Nabizzle/Hexapod/Docs/Kinematics Calculations/Hexapod Kinematics Calculation.pdf

# Kinematics Calculations for Hexapod Robot

### Nabeel Chowdhury

### October 10, 2021

1

## 1 Servo Angles for each Leg

Looking from above, the first angle of each leg that makes contact with the floor at P(x, y, z) is found as θC = tan⁻¹

Ly
Lx
= tan⁻¹
Py
Px

x

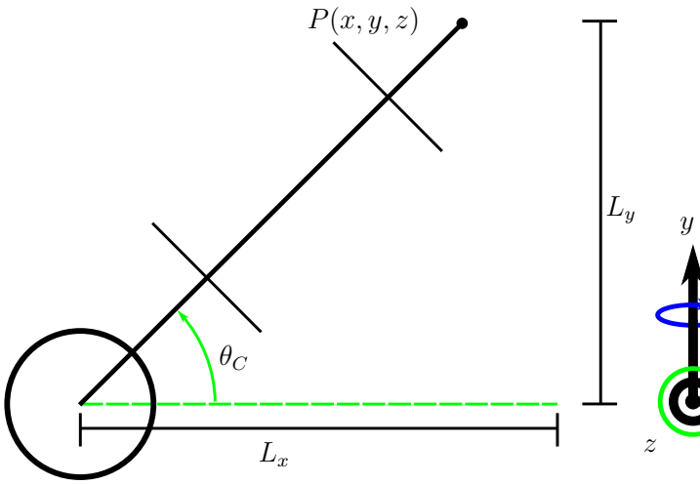
[picture p3: figure]

Figure 1: The top view of the leg. θC is the Coax angle of the servo attached to the body of the Hexapod. Lx is the length of the leg from the body in the x direction and Ly is the length of the leg in the y direction.

2

Looking from the side of the leg, we can define several parameters.

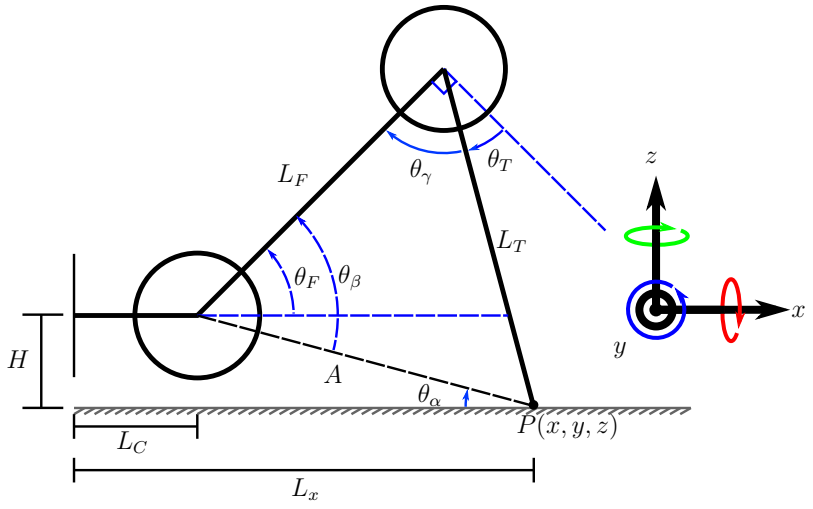
[picture p4: figure]

Figure 2: The side view of the leg. θF is the Femur angle and θT is the tibia angle. LC is the offset of the femur servo from the body, or the coax length. LF is the length of the Femur and LT is the length of the Tibia. Lx is the x distance of the leg’s point of contact with the ground. H is the height of the body off of the ground. The rest of the parameters are needed in interim steps to find θF and θT .

First, we need to find the length of A.

A =

q
H² + (Lx − LC)

2 =

q
P²
z + (Px − LC)

2

Using A we can use the law of cosines to find θF .

θF = θβ − θα

θα = tan⁻¹

H
Lx − LC

L

2
T = L

2
F + A

2 − 2LFA cos(θβ)

∴ θF = cos⁻¹

L

2
T − L

2

F − A²
−2LFA
− tan⁻¹
H
Px − LC

3

We can also use the law of cosines to find the tibia angle as well.

−θT = 90◦ − θγ

A

2 = L

2
F + L

2
T − 2LF LT cos(θγ)

∴ θT = cos⁻¹

A² − L

2
F − L

2
T
−2LF LT
− 90◦

In summary:

θC = tan⁻¹

Py
Px

θF = cos⁻¹

L

2
T − L

2
F − P

2
z − (Px − LC)

2

−2LF

q
P²
z + (Px − LC)

2

⁻ tan⁻¹

−Pz
Px − LC

θT = cos⁻¹

P

2
z + (Px − LC)

2 − L
2
F − L

2
T
−2LF LT

!
− 90◦

4

## 2 Converting Leg Origin to Body Origin

In order to find how all of the legs will move together, the origins of each leg need to be shifted from their body attachment points to the body center. Shown in the image below is a top down view of the hexapod body with the leg attachment points labeled as xn, yn, zn with n = 0, 1, 2, 3, 4, 5 to corre-spond to the leg numbers in the code. in the default position, the offset of the legs from the body are a known number, but each offset will change as the body rotates in place. This will be explored later.

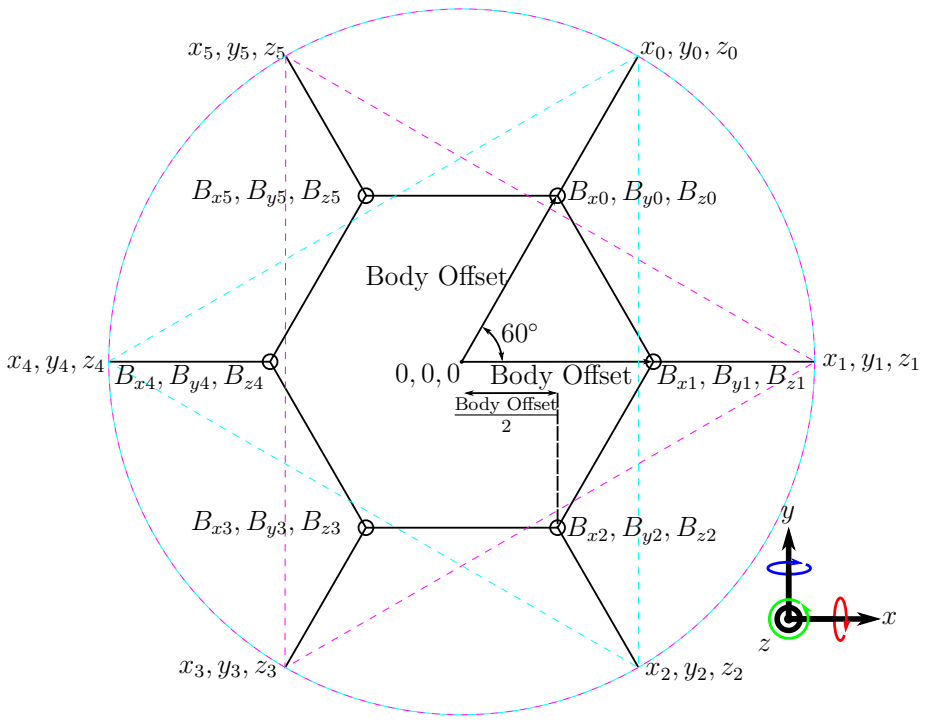
[picture p5: figure]
Body Offset; Body Offset 2

Figure 3: The top view of the whole body with each leg attachment point labeled with x, y, and x values.

The position of each leg endpoint can be found using the body offset plus

5

the leg’s position from the body attachment.

xn = Bxn + Pxn where: n = 0, 1, 2, 3, 4, 5
yn = Byn + Pyn where: n = 0, 1, 2, 3, 4, 5
zn = Bzn + Pzn where: n = 0, 1, 2, 3, 4, 5

### 2.1 Body Offset Changes Due to Rotation

Each body offset will change based on the rotation of the body. This could be solved using trigonometry like for the legs, but a simpler, global solution is to use rotation matrices and find where each leg attachment point is moved to in space. A change in pitch is a rotation around the x axis, a change in roll is a rotation around the y axis, and a change in yaw is a rotation around the z axis.

### 2.1.1 Rotation Matrices

The rotation matrices are below:

Rotation About the X Axis

Rx =

1 | 0 | 0
0 | cos(θ) | sin(θ)
0 − sin(θ) cos(θ)

Rotation About the Y Axis

Ry =

cos(θ) | 0 sin(θ)
0 | 1 | 0
− sin(θ) 0 cos(θ)

Rotation About the Z Axis

Rz =

cos(θ) sin(θ) 0
− sin(θ) cos(θ) 0
0 | 0 | 1

6

To find the new endpoints, we do the following calculation:

B⁰
xn
B⁰
yn
B⁰
zn
- = (RzRyRx)

−1

Bxn

Byn

Bzn

- where: n = 0, 1, 2, 3, 4, 5

Therefore, the endpoints of each leg in relation to the body center is:

xn
yn
zn
- = (RzRyRx)

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
- where: n = 0, 1, 2, 3, 4, 5

### 2.2 Body Offset Changes Due to Body Translation

When the body of the hexapod translates in place, the only change that is needed is to add the translation to each offset. Assuming there is a desired translation of [Tx, Ty, Tz], the body offsets will be:

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
- where: n = 0, 1, 2, 3, 4, 5

### 2.3 Combined Body Offset Changes

The combined changes to the body offsets is below:

B⁰
xn
B⁰
yn
B⁰
zn
- = (RzRyRx)

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
- where: n = 0, 1, 2, 3, 4, 5

## 3 Hexapod Turning

Turning the hexapod is slightly different from the rotation of the body alone as the act of turning the whole hexapod requires rotating the origin point. Here we take leg 1 as an example with a small left turn with an angle of α.

The first thing we need to find is the angle the leg end point makes withe the center of the body before the turn. this is found as:

θa = tan⁻¹

yn
xn

7

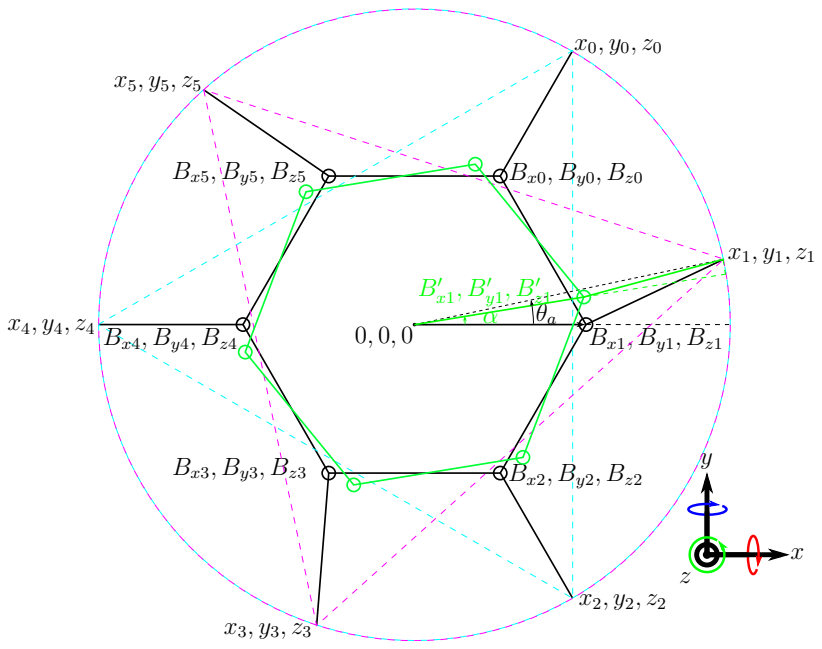
[picture p6: figure]

Figure 4: The hexapod taking a small left turn.

Now we can use the previous rotation matrices to find the length of the leg from the body.

θa = tan⁻¹

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
- − (RzRyRx)

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
- where: n = 0, ..., 5

The length of the leg from the body is L =

p
P²
xn + P²
yn
In the rotated coordinate frame, we can use the original body offset distances and the length of the leg to find the new leg end point position in the rotated global coordinate frame.

8

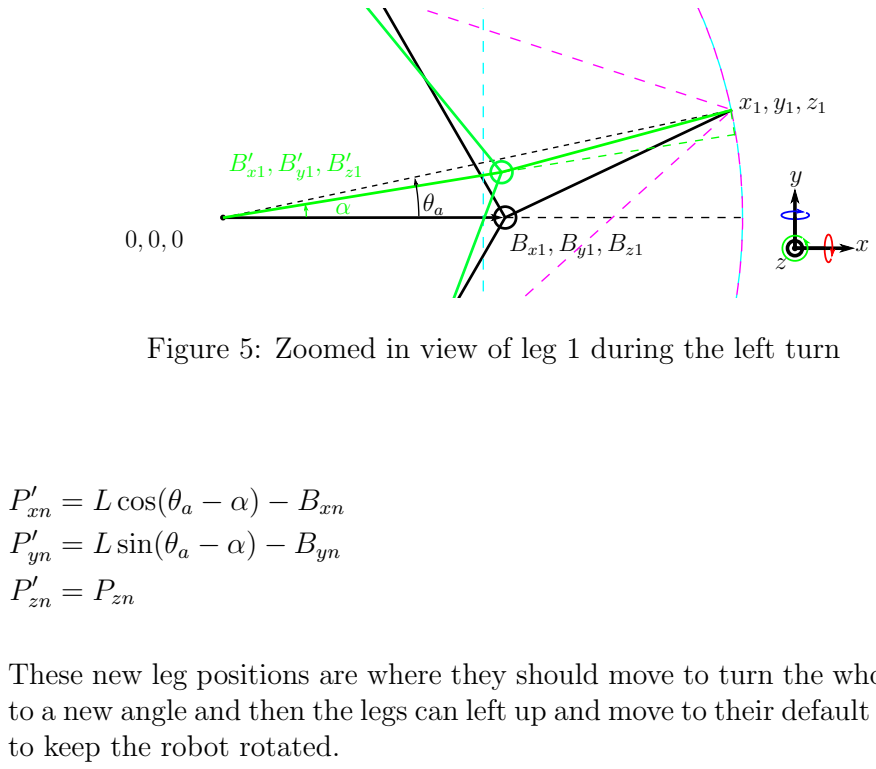
[picture p7: figure]
0 xn = L cos(θa − α) − Bxn; 0 yn = L sin(θa − α) − Byn; 0 zn = Pzn; to keep the robot rotated.

Figure 5: Zoomed in view of leg 1 during the left turn

These new leg positions are where they should move to turn the whole body to a new angle and then the legs can left up and move to their default position

9

## 4 Hexapod Translation in the XY Plane

Having the hexapod move in any direction level to the ground is simple. The position of the end points of the legs is the opposite of movement of the center of the body. Therefore, the new position of the legs is found using the

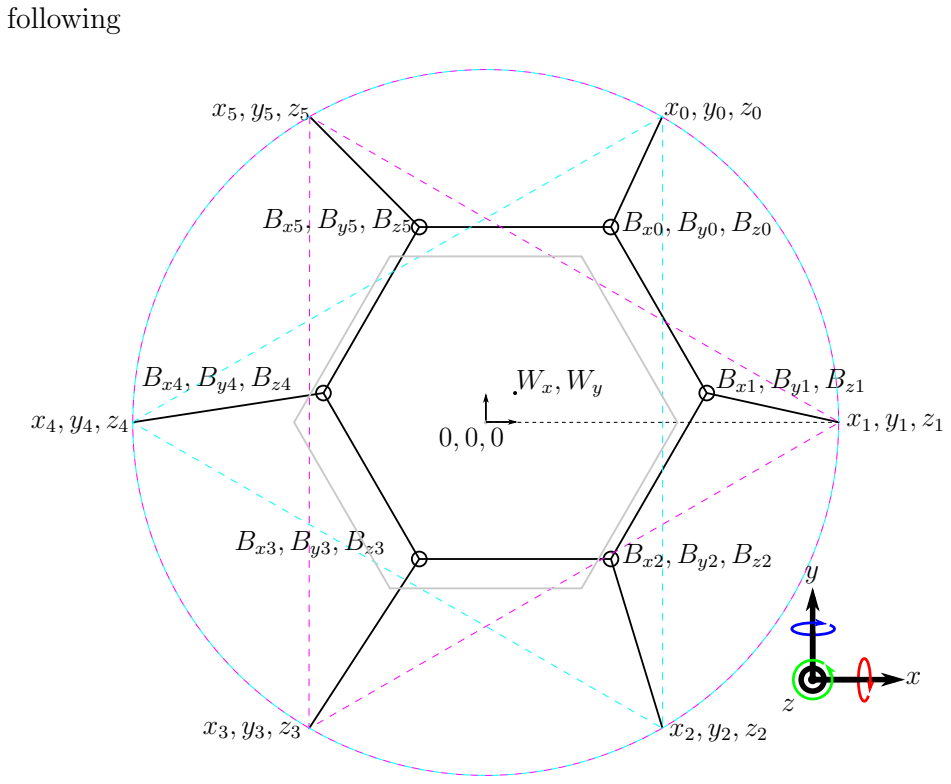
[picture p8: figure]
following

Figure 6: The top view body when making a motion in the xy plane.

P

0
xn = Pxn − Wx
P

0
yn = Pyn − Wy

P

0
zn = Pzn

10

## 5 Hexapod Alternative Walk Cycle

When the hexapod makes a motion two alternative sets of legs move. One set stays on the ground to form a tripod and the other moves off the ground and into position. The legs will always for an equilateral triangle. For the legs that move off of the ground, the calculation should be made so that it assumes that the origin moved in the opposite direction of the actual motion. Then the second set of legs comes off the ground and does the same.

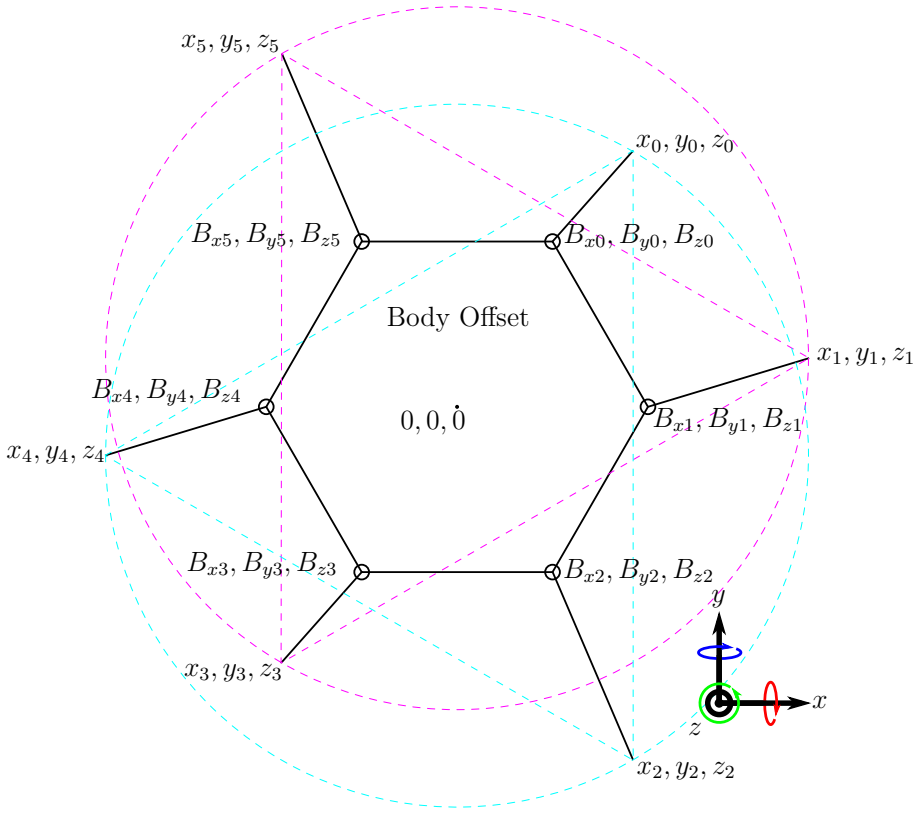
[picture p9: figure]
Body Offset

Figure 7: The alternative tripod walk of the hexapod.

11
