Nabizzle/Hexapod/Docs/Media/side leg.dxf

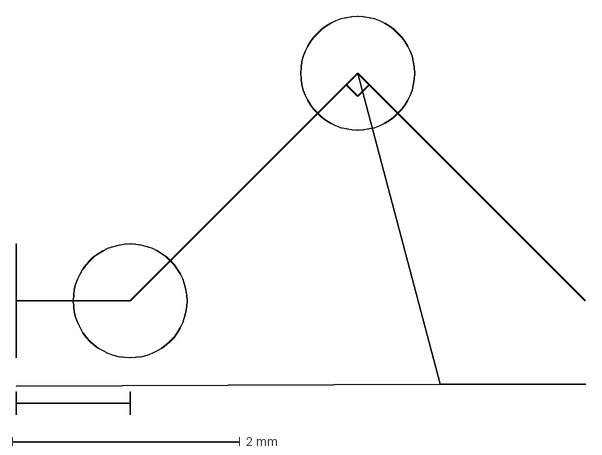
[picture p10: CAD file, 2021-10-02]
Docs/Media/side leg.dxf
5.00 x 3.50 mm
