Nabizzle/Hexapod/Docs/Media/top leg.dxf

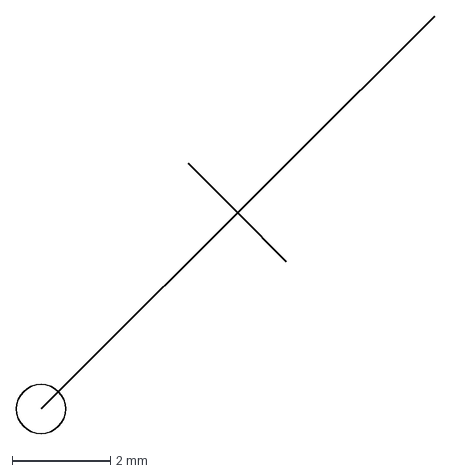
[picture p11: CAD file, 2021-10-02]
Docs/Media/top leg.dxf
8.51 x 8.49 mm
