Nabizzle/Hexapod/Docs/Body Schematics/Left Leg Assembly Drawing v4.pdf

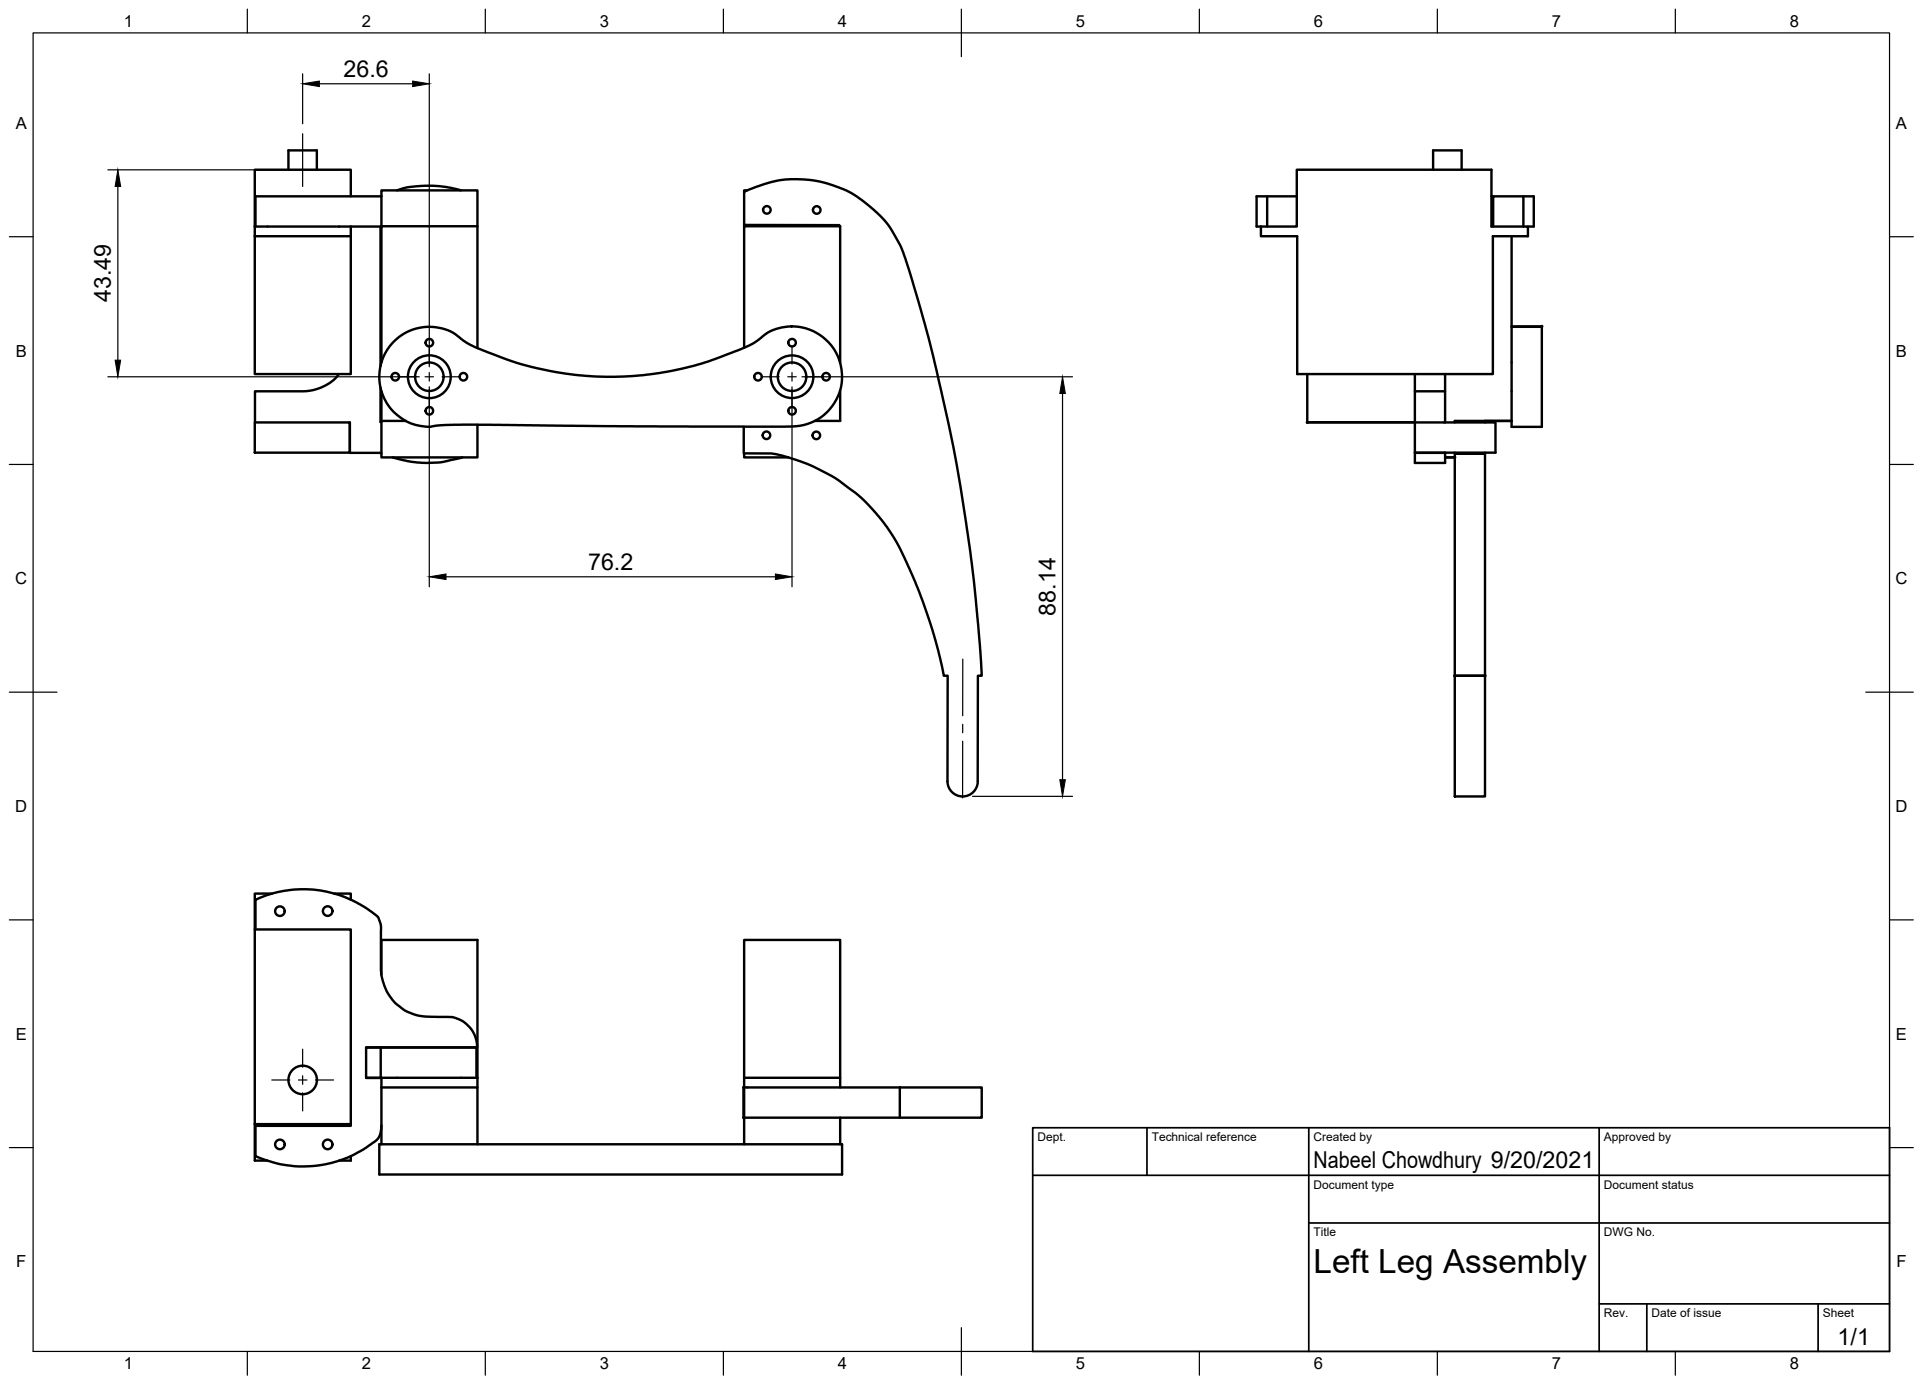
[picture p12: page 1]
Title; DWG No.; Rev.; Date of issue; Sheet

Dept. | Technical reference | Created by Nabeel Chowdhury 9/20/2021 | Approved by

Document type | Document status

Left Leg Assembly
