Nabizzle/Hexapod/Docs/Body Schematics/Circular Body Drawing v2.pdf

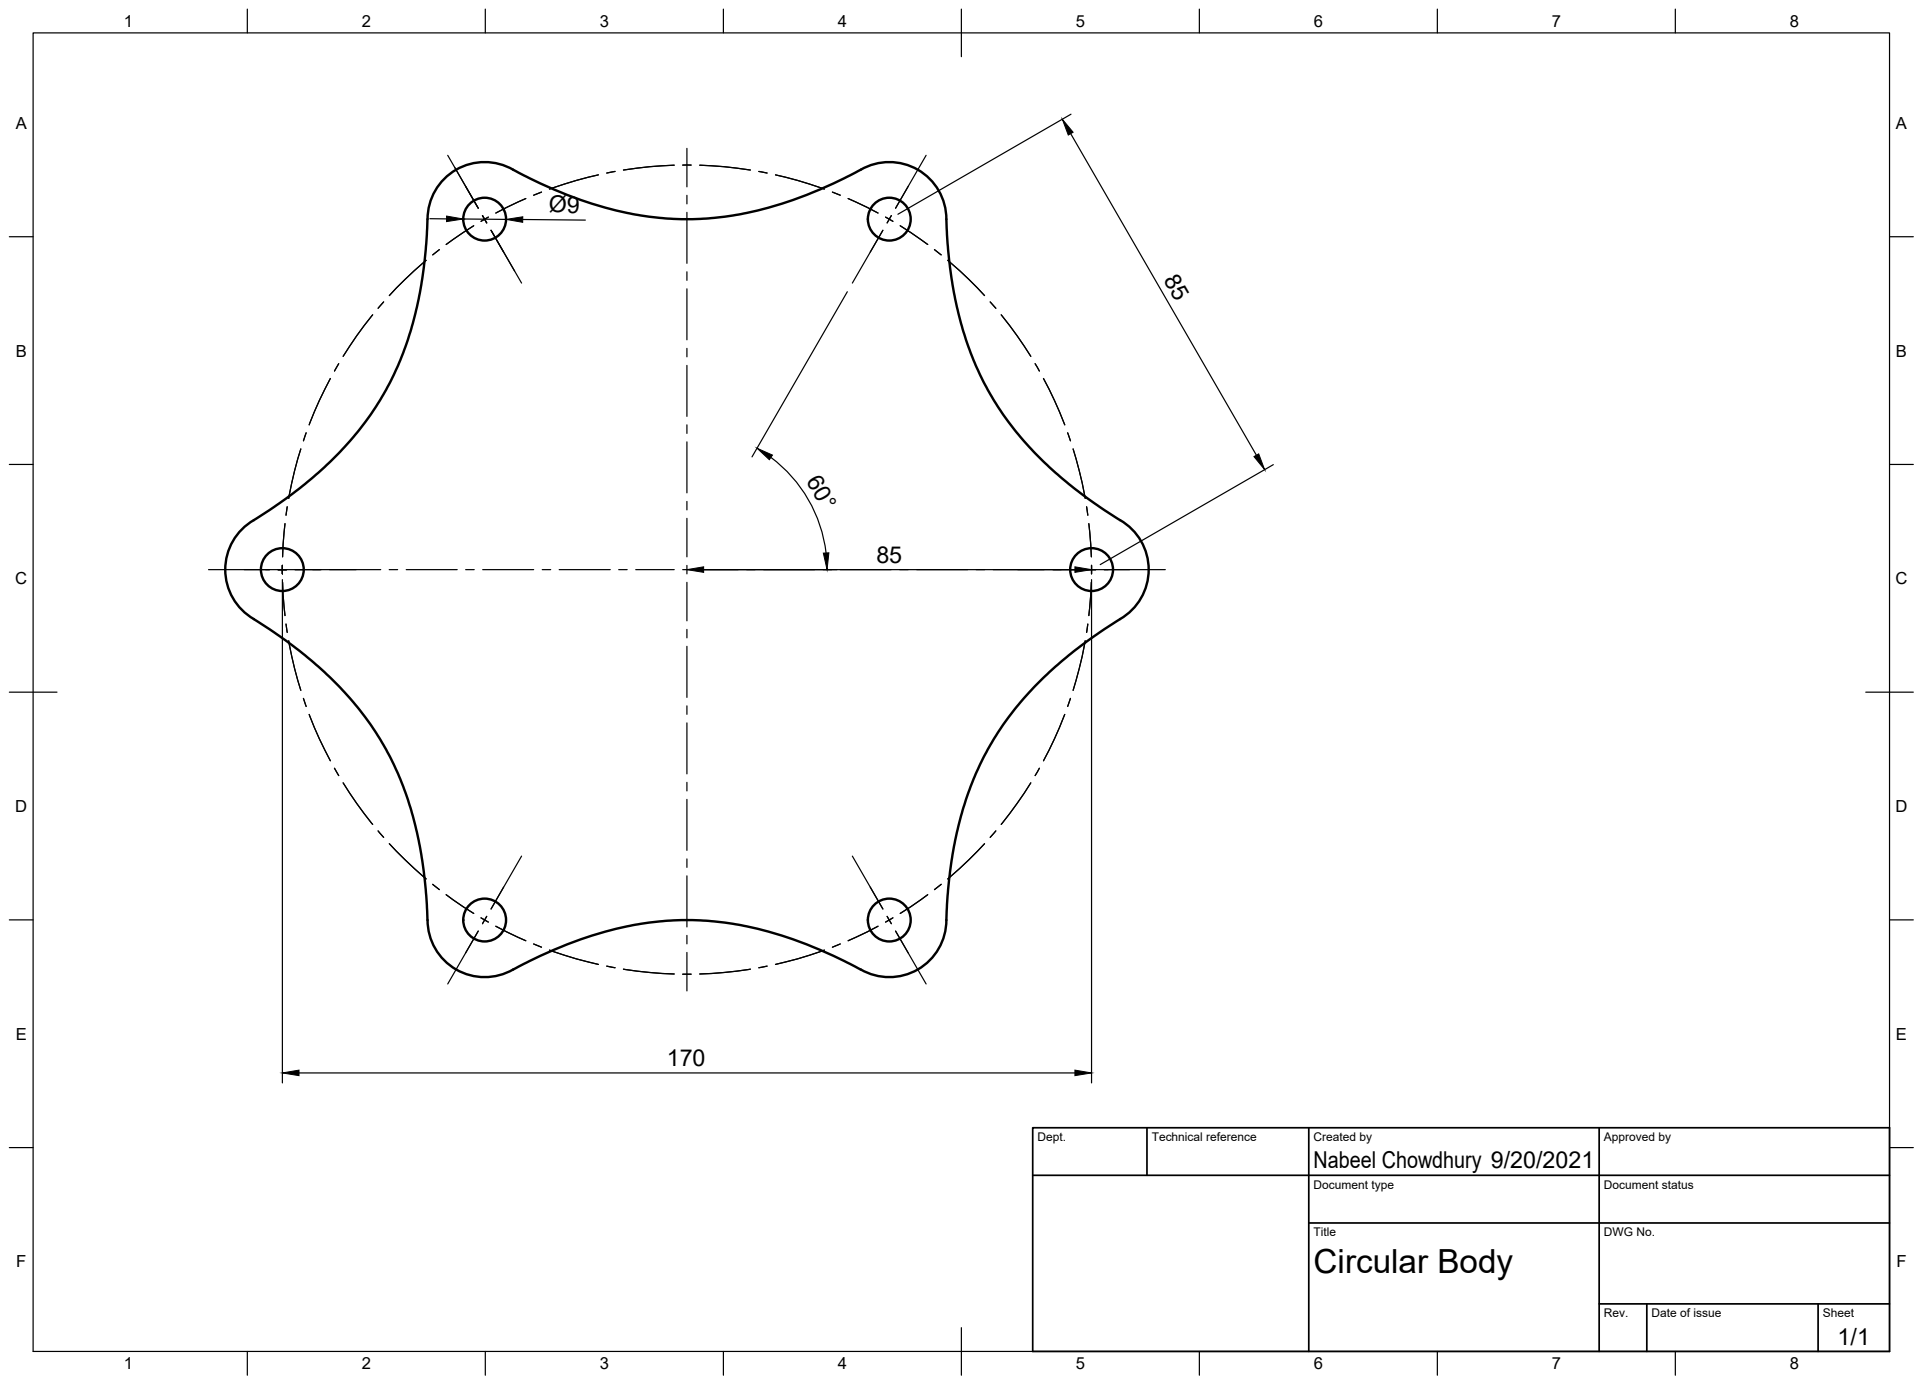
[picture p13: page 1]
Title; DWG No.; Rev.; Date of issue; Sheet; Circular Body

Dept. | Technical reference | Created by Nabeel Chowdhury 9/20/2021 | Approved by

Document type | Document status
