Nabizzle/Hexapod/Code/hexapod/hexapod/body.py

"""
Functions related to calculating the points in x, y, z space that make up the
body model.

Functions in this model are used to take in desired angles and translations to
orient the body in whatever way the user desires independent of the legs and
their movement.

Functions
---------
bodyAngle:
    Finds the body angles based on analog stick inputs
bodyPos:
    Creates a model of the body with input rotations and translations.
"""
from typing import Tuple
import numpy as np
from numpy.linalg import inv
from hexapod.rotation import xRot, yRot, zRot
from math import sin, tan, atan2, pi, radians, degrees


def bodyAngle(analog_x: float, analog_y: float,
              max_angle: float = 15) -> Tuple[float, float]:
    """
    Finds the body angles based on analog stick inputs

    Finds the body roll and pitch angles based on an single analog stick input
    up to a maximum angle

    Parameters
    ----------
    analog_x: float
        The distance the analog stick is pushed in the x direction normalized
        between -1 and 1
    analog_y: float
        The distance the analog stick is pushed in the y direction normalized
        between -1 and 1
    max_angle: float, default 15
        The maximum angle the body will dip by

    Returns
    -------
    pitch, roll: Tuple[float, float]
        The found roll and pitch angles to update the body with.
    """
    max_depth = -tan(radians(max_angle))
    pitch = degrees(atan2(max_depth * analog_y, 1))
    roll = degrees(atan2(max_depth * analog_x, 1))
    return (pitch, roll)


def bodyPos(pitch: float = 0, roll: float = 0, yaw: float = 0, Tx: float = 0,
            Ty: float = 0, Tz: float = 0,
            body_offset: float = 85) -> np.ndarray:
    """
    Creates a model of the body with input rotations and translations.

    Applies rotations in `pitch`, `roll`, and `yaw` and translations in x, y,
    and z to the body. After this, it creates a model of the hexapod's body
    that represents the locations of the coax servo output shafts.

    Parameters
    ----------
    pitch: float, default=0
        The rotation of the body about the x axis.roll
    roll: float, default=0
        The rotation of the body about the y axis.
    yaw: float, default=0
        The rotation of the body about the z axis.
    Tx: float, default=0
        Translation of the body along the x axis.
    Ty: float, default=0
        Translation of the body along the y axis.
    Tz: float, default=0
        Translation of the body along the z axis.
    body_offset: float, default=85
        The distance in millimeters along the x axis of the second coax angle
        servo from the center of the hexapod when the body has no translations
        or rotations.

    Returns
    -------
    body_model: np.ndarray
        A 7x3 numpy array that represents the locations of the coax servos as
        x, y, and z points.

    Notes
    -----
    The seventh point in the model is the same as the first and was used when
    plotting the model, but is not needed in controlling the hexapod.
    """
    body_rot = np.matmul(zRot(yaw), yRot(roll))
    body_rot = np.matmul(body_rot, xRot(pitch))

    body_0 = np.matmul(inv(body_rot), np.array([[body_offset / 2,
                                                 body_offset * sin(pi / 3),
                                                 0]]).T)
    body_1 = np.matmul(inv(body_rot), np.array([[body_offset, 0, 0]]).T)
    body_2 = np.matmul(inv(body_rot), np.array([[body_offset / 2,
                                                 -body_offset * sin(pi / 3),
                                                 0]]).T)
    body_3 = np.matmul(inv(body_rot), np.array([[-body_offset / 2,
                                                 -body_offset * sin(pi / 3),
                                                 0]]).T)
    body_4 = np.matmul(inv(body_rot), np.array([[-body_offset, 0, 0]]).T)
    body_5 = np.matmul(inv(body_rot), np.array([[-body_offset / 2,
                                                 body_offset * sin(pi / 3),
                                                 0]]).T)

    body_model = np.concatenate((body_0.T, body_1.T, body_2.T, body_3.T,
                                 body_4.T, body_5.T, body_0.T), axis=0)
    translation = [[Tx, Ty, Tz],
                   [Tx, Ty, Tz],
                   [Tx, Ty, Tz],
                   [Tx, Ty, Tz],
                   [Tx, Ty, Tz],
                   [Tx, Ty, Tz],
                   [Tx, Ty, Tz]]

    body_model = body_model + translation

    return body_model
