Nabizzle/Hexapod/Code/hexapod/tests/test_move.py

from hexapod import move
import numpy as np
import pytest


def test_stepForward():
    """Tests that the output feet offsets from making one step forward are correct"""
    assert np.allclose(move.stepForward(step_angle=90, distance=30,
    step_height=15, right_foot=True, z_resolution=1),
                       np.array([[[0.00000e+00, 0.00000e+00, 0.00000e+00],
                                  [-0.00000e+00, -0.00000e+00, 0.00000e+00],
                                  [0.00000e+00, 0.00000e+00, 0.00000e+00],
                                  [-0.00000e+00, -0.00000e+00, 0.00000e+00],
                                  [0.00000e+00, 0.00000e+00, 0.00000e+00],
                                  [-0.00000e+00, -0.00000e+00, 0.00000e+00]],

                                 [[6.12323e-17, 1.00000e+00, 7.25000e+00],
                                  [-6.12323e-17, -1.00000e+00, 0.00000e+00],
                                  [6.12323e-17, 1.00000e+00, 7.25000e+00],
                                  [-6.12323e-17, -1.00000e+00, 0.00000e+00],
                                  [6.12323e-17, 1.00000e+00, 7.25000e+00],
                                  [-6.12323e-17, -1.00000e+00, 0.00000e+00]],

                                 [[1.22465e-16, 2.00000e+00, 1.40000e+01],
                                  [-1.22465e-16, -2.00000e+00, 0.00000e+00],
                                  [1.22465e-16, 2.00000e+00, 1.40000e+01],
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
                                [-7.50000e+01, -1.01404e+02, -2.00000e+01],
                                [-1.50000e+02, -2.85000e+01, -1.27500e+01],
                                [-7.50000e+01, 1.58404e+02, -2.00000e+01]],
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
