Nabizzle/Hexapod/(commit log)

2021-10-02 docs: Adds documentation for leg servo angles
    The currenct documentation finds the angles of the servos when using the
    leg's attachment point to the body as the origin.
    Future additions should find the angles using the body's center as the
    origin as well as find how the angles change with body roll, pitch, and
    yaw.
    [side leg.dxf, top leg.dxf]
2021-10-05 feat: Adds base Hexapod Model
    Adds the hexapod model at its starting position and defines rotation
    matricies that will be used to calculate the positions of the body and
    legs as servo angles change.
2021-10-05 feat: Creates a function to find leg postion
    Takes the code that individually found each leg position using hard
    coded values and makes it a function that takes in servo angles and leg
    number
2021-10-05 fix: Changes leg angle name
    Changes legAngle to legPos because the method finds the position of the
    legs from the angles
2021-10-05 feat: Adds method to find servo angles of leg
    Adds a method to find the servo angles of the leg using the body
    attachment as the origin. This follows the current documentation for the
    inverse kinematics and will need to be updated when all kinematics are
    found using the center of the body as the origin.
2021-10-05 docs: Adds schematics for the Hexapod parts
    Adds images with measurments for the legs and body of the hexapod.
2021-10-06 feat: Adds function to find body position
    Adds a new function to find the body position with a pitch, roll, and
    yaw angle
2021-10-10 docs: Adds calculation for finding how to turn
    Closes #4 issue with the documentation of how to find leg positions in a
    rotated global frame.
2022-01-02 Creates a start position for the robot
    Calculates the start positions for each of the legs and compensates for
    any body rotations. Also addresses the fact that the Coax angle for each
    leg will affect the calcuation of the femur and tibia angles.
    Fixes #6
2022-01-03 feat: Optimizes code slightly
    Makes the code to find the starting positions of the legs into a
    function that outputs a 2D array to joint angles. Also converts the leg
    model from 6 individual 2D arrays to a 3D array of positions
2022-01-03 feat: Adds more leg functions
    Adds functions to find the current feet positions, recalculate the leg
    joint angles based on a 2D array of feet positions, and create the leg
    model based on leg angles. ALso passes the body and leg models into the
    showModel method.
2022-01-05 feat: Adds a walking cycle
    Changes the code to better visualize a walking cycle, creates a function
    to figure out how to break up a distance to walk into a variable number
    of steps, and fixes syntax errors in the code found in the recalculate
    leg angles code. The code to find the starting leg positions had to be
    adjusted as a result.
    Fixes #7
2022-01-26 feat: Adds functions to step
    Adds funcitions to calculate a step and find where each leg needs to
    step to. This commit was made with some debug code still attached for
    testing this code at the bottom of the notebook. This commit also adds
    documentation to the walk cycle function. The turn cycle cell is in
    progress and is NOT a fully working cell.
2022-01-27 doc: Changes step functions names
    Changes names to be camel case with other formatting of function names
2022-03-16 feat: Adds rotations functions and updates setup
    Adds the functions to calculate the rotation matricies and to test them
    with 90 degree rotations. These functions replace the "myfunctions"
    scripts. Also updates the setup file accordingly.
    [test_rotation.py]
2022-03-16 feat: Adds code and tests for the leg functions
    Adds all of the functions for the legs from the jupyter notebook with
    tests that have the relevant inputs hard coded. This way each function
    does not rely on any other function to be working to by tested.
2022-04-02 feat: Adds functions to convert EMG to walking
    There still needs to be a function to poll EMG values from the raspberry
    pi zero. This relies on issue #11.
2022-04-02 fix: Changes walk and turn function calls
    Eliminates the body_model inputs that were eliminated from the move.py
    scripts.
    [test_move.py]
2022-04-14 feat: Adds the driver for the Lynxmotiohn SSC-32U
    Creates scripts and tests for converting a servo angle to a pulse width
    used in PWM and to create the grouped command for all the servos using
    their desired angles. Currently all servos have the same speed. Also
    adds scripts for connecting and disconnecting to the serial port and
    sending the serial command to the Lynxmotiohn SSC-32U. These functions
    are not tested as they also requiere the Lynxmotiohn SSC-32U.
    Closes #16 issue.
    [ssc32uDriver.py, test_ssc32uDriver.py]
2022-04-14 feat: Creates library for pi to pi communication
    Creates the file to store the raspberry pi to raspberry pi communication
    files. This should hold the files for the TCP IP connection and polling
    the EMG sensors.
2022-04-14 feat: Changes the emg polling function output
    The EMG polling function now sends back both the EMG sensor outputs and
    constrains both values to a number from 0 to 1.
2022-04-14 feat: Uses both emg sensors in walking and turning
    Now the two emg sensors will allow the robot to move forwards and back
    wards or turn right or left based on which EMG value is higher
2022-04-14 perf: EMG movement fucntions step once
    These functions move only take a single step and output the leg model, the
    current state of which legs should move next, and the previous step so
    that the funcitons can be called over and over again. Note that there
    needs to be a reset function so that the stance resets before the
    hexapod switches modes.
    [test_move.py]
2022-04-14 test: Adds a test for the resting walking stance
    In making the test, many errors were fixed in the funciton addressed by
    the next commit
    [test_move.py]
2022-04-14 fix: Updates the right foot and leg model
    The foot boolean and the leg model were not updated after the function
    was run previous to this commit
2022-04-14 fix: Updates the leg model for the ending stance
    Updates the leg model in the EMG based walking and turning to reflect
    the ending stance of the robot after the servos have moved
2022-04-14 feat: Adds a reset turning stance function
    Resets the stance of the robot when ending turning or switching modes
    This accomplishes someting abondoned in Issue #14
2022-04-14 test: Adds test for reseting turn stance
    [test_move.py]
2022-04-14 feat: Allows a 2D array of angles
    Allows the currently output of the recalculate leg angles script to
    directly input to the servo driver
2022-04-14 test: Updates the reset stance tests
    Makes the assertion more readable
    [test_move.py]
2022-04-14 perf: The switch modes script polls EMG
    The switch modes script polls the EMG instead of havning it passed in.
2022-04-14 feat: Adds a controller for the hexapod
    The controller combines the important scripts to get the robot moving.
    It decides if the hexapod should walk, turn, or switch modes and it also
    sends the positions to the servo controller.
    Closes #15 issue
    [controller.py]
2022-04-14 fix: Calls sleep command correctly
    [controller.py]
2022-04-14 test: Updates the switch mode test
    Updates the test for the EMG being polled. In the future, this test will
    not work unless the subject is cocontracting so the test may need to be
    removed.
    [test_move.py]
2022-04-14 fix: Deletes incorrect import
    [controller.py]
2022-04-15 fix: Corrects the call to the sendData function
    [controller.py]
2022-04-15 fix: Removes unused import
    [ssc32uDriver.py]
2022-04-15 fix: Eliminates unnecessay else
    [ssc32uDriver.py]
2022-04-15 fix: Removes unnecessary variables
    [test_move.py]
2022-04-15 refactor: Fixes visual indent
    [test_move.py]
2022-04-15 fix: deletes extra spaces after operator
    [leg.py, ssc32uDriver.py]
2022-04-15 fix: fixes visual indent
    [body.py, leg.py]
2022-04-15 fix: removes space after opening bracket
    [test_leg.py, test_move.py]
2022-04-15 fix: Fixes call to serial port state
    [ssc32uDriver.py]
2022-04-15 test: Tests the servo controller
    In testing I found the message needed to be incoded as ASCII bytes, but
    all 18 servos work in the group command.
    Closes #26 issue
    [ssc32uDriver.py]
2022-04-15 fix: Adds the command to send start servo angles
    [controller.py]
2022-04-15 chore: Adds the mcp3xxx library as required
    This library is required to connect to the MCP3008 which is an ADC for
    recording the EMG values
2022-04-15 feat: Adds code to record EMG
    Adds the code to record from the ADC to get the forearm EMG values.
    Issue #11 still needs to be addressed to send this data wirelessly to
    the other raspberry pi, but this script will record the EMG. When the
    wireless communication is made, the pollEMG function will need to
    incorporate it somehow.
    Closes #12 issue
    [piToPi.py]
2022-04-16 feat: Adds a sitting function
    Adds a function to send a signal for the hexapod to sit.
    Closes #25 issue. The hexapod will stand when the main controller is
    activated.
    [controller.py]
2022-04-16 fix: Adjusts angles to match servo orientation
    The servos on the robot turn thier body segments based on their
    attachment to the robot. This was not addressed in the computational
    model and needed to be corrected for in the driver for the servos.
    [ssc32uDriver.py]
2022-04-16 test: Updates the anglesToSerial command
    Updates the angles to serial command to look for the correct format of
    the message in bytes and correct pulse width values
    [test_ssc32uDriver.py]
2022-04-16 test: Deletes the switch modes test
    Deleted the test as it requires the pollEMG script. This script needs to
    be connected to the raspberry pi zero at the time to work
2022-04-16 fix: Corrects the angle adjustments
    The original angle adjustments were made assuming the servos rotated in
    the oposite direction.
    [ssc32uDriver.py]
2022-04-18 docs: Fixes the doc string formatting in functions
    [body.py, controller.py, leg.py, ssc32uDriver.py]
2022-04-18 refactor: Indents continuation lines correctly
    Fix for visual indent
    [body.py, leg.py]
2022-04-18 docs: Corrects doc line length
    [body.py, controller.py, leg.py, piToPi.py, ssc32uDriver.py]
2022-04-18 fix: Formats multiline doc strings
    [body.py, controller.py, leg.py, piToPi.py, ssc32uDriver.py]
2022-04-19 refactor: Fixes over indented lines
    Done for visual stylet
    [leg.py]
2022-04-19 !Breaking Change: Disables the board import
    Disables for testing. Needs to be reenabled
2022-04-19 fix: Imports board again
    [piToPi.py]
2022-04-19 docs: Adds type annotation to all functions
    The types for the serial ports are labeled as any. Also many functions
    that returned lists are said to return Tuples. May actually want those
    functions to return Tuples so that their outputs are imutible.
2022-04-19 fix: fixes style issues
    [leg.py]
2022-04-20 fix: Addresses style issues
    [body.py]
2022-04-20 docs: Updates the docstrings of the leg module
    Adds much more detail to the leg module's documentation.
2022-04-20 test: Updates test_startLegPos
    Updates the test with the correct parameters
    [test_leg.py]
2022-04-23 fix: Improves sit function
    [controller.py]
2022-04-23 fix: Adjusts neutral standing parameters
    [controller.py]
2022-04-23 fix: Prevents input angles from being overwritten.
    The anglesToSerial function was overwriting the input angles when it was
    making the message. To address this, a copy of the array is used as a
    temporary variable in the calculations.
    [ssc32uDriver.py]
2022-04-23 fix: Fixes angle conversion
    [ssc32uDriver.py]
2022-04-23 fix: Addresses style issue.
    [controller.py]
2022-04-24 tests: Adds a test for servo angles of 0
    Tests that the if statements for making the servo angles 0 works.
2022-04-25 fix: Addresses documentation style issue
    [test_move.py]
2022-04-25 feat: Smoothes servo angle change
    Takes 5% of the next servo angle to move to and 95% of the previous
    servo angle
    Closes #27 issue
    [controller.py]
2022-04-25 fix: Corrects style issue
    [controller.py]
2022-04-26 fix: Corrects servo smoothing
    The smoothest servo movement was more from a z_resolution of 10 and not
    form smoothing the servos with a previous and next servo angle. This is
    because the interum postions were already found and didn't need
    smoothing. The calculation done was the smoothing and I just needed to
    use bigger gaps in movement.
    Closes #27
    [controller.py]
2022-04-26 tests: Adds serial port tests
    Adds test for connection error, disconnecting, and sending data error.
    [test_ssc32uDriver.py]
2022-04-26 fix: Fixes bug risk in tests
    [test_ssc32uDriver.py]
2022-04-26 tests: Specifies Error type/
    [ssc32uDriver.py, test_ssc32uDriver.py]
2022-04-26 tests: Adds a switchMode test
2022-05-10 fix: Fixes spelling of recieve
    [piToPi.py]
2022-05-12 feat: Adds wireless communication scripts
    Uses a TCPIP connection to send EMG data.
    Partially addresses issue #11
    [piToPi.py]
2022-05-12 feat: Adds TCPIP function to the move library
    Adds the call to the socket in the relevant functions
    Closes #11 issue
2022-05-12 feat: Adds input for usb port name.
    Allows the usb port to be named. This addresses the incompatibility of
    using COM ports on windows and ttyUSB ports on linux/raspberry pis.
    [controller.py]
2022-05-13 fix: Addresses test import error
    Makes the board import optional because it was messing with the import
    of the test_move pytests.
    Closes #30
    [piToPi.py, test_move.py]
2022-05-14 feat: Splits out the creation of the analog inputs
    Creates a new function to create the analog inputs outside of getting
    the EMG values.
    Closes #29 issue
    [piToPi.py]
2022-05-14 Revert "chore: controller library to emgController"
    This reverts commit 485e439768827a29c6c2b7cfdf70d7c74ee7aa36.
    [controller.py]
2022-05-15 tests: Updates the turning tests
    Related to issue #28
    [test_move.py]
2022-05-15 feat: Creates class to us an xbox one controller
    Uses the inputs python library to conntect to an xbox one controller and
    poll all buttons, analog sticks, and triggers. The class for this has a
    read function to return all controller values.
    Closes #31 issue
2022-05-15 chore: Changes thread function name
2022-05-16 feat: Adds code to find body angles
    Finds body pitch and roll from an analog input
    Closes #34 issue
    [body.py]
2022-05-16 chore: Reorganized library
    Moved switchMode and pollEMG to the piToPi library as it makes more
    sense for them to be there.
2022-05-16 fix: Addresses syntax and bug issue
    [controller.py]
2022-05-16 fix: switchModel imported from wrong library
    [controller.py]
2022-05-16 tests: Updates resetWalkingStance test
    [test_move.py]
2022-05-30 feat: Adds mapping of controller to movement modes
    Adds an untested switch case to move the hexapod.
    Closes #13 issue
    [controller.py]
2022-05-30 docs: Fixes spelling issues
    [body.py, piToPi.py, xboxController.py]
2022-05-30 fix: Deletes trailing white space
    [controller.py]
2022-05-30 Tests the game pad controller code virutally
    Closes #35 issue
    [controller.py]
2022-05-30 docs: Fixes spelling mistakes
    [leg.py, ssc32uDriver.py, test_leg.py, test_move.py, test_ssc32uDriver.py]
